GeekInternet/Alarm-Monitoring/Node-Red/Alarm Interface Flow.png

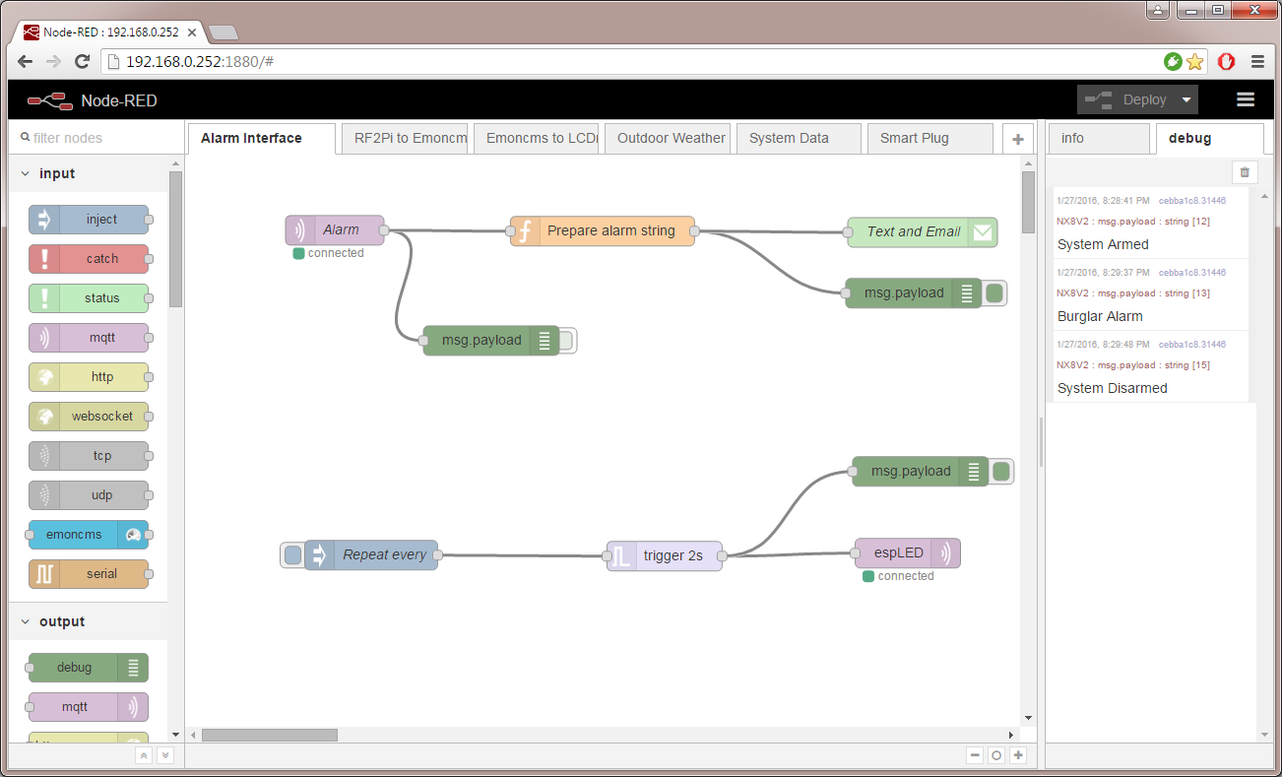
Node-Red/Alarm Interface Flow.png
