GeekInternet/Alarm-Monitoring/Schematic/Alarm Monitoring with ESP8266.pdf

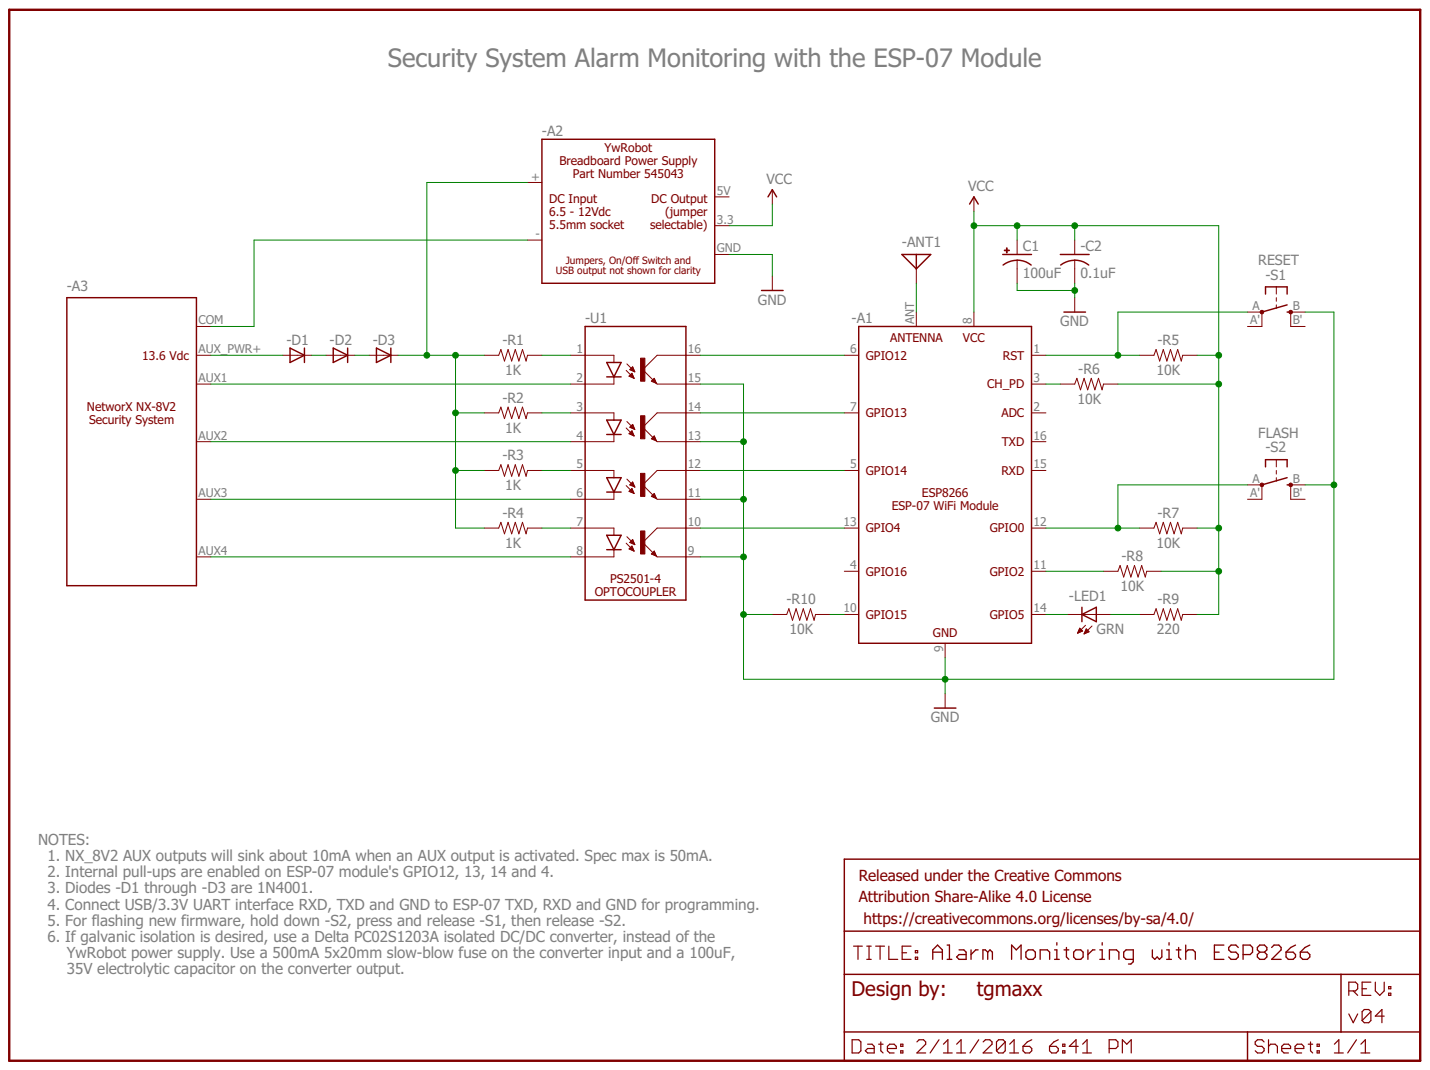
[picture p4: page 1]

Security System Alarm Monitoring with the ESP-07 Module

Jumpers, On/Off Switch and USB output not shown for clarity

NOTES: 1. NX_8V2 AUX outputs will sink about 10mA when an AUX output is activated. Spec max is 50mA. 2. Internal pull-ups are enabled on ESP-07 module's GPIO12, 13, 14 and 4. 3. Diodes -D1 through -D3 are 1N4001. 4. Connect USB/3.3V UART interface RXD, TXD and GND to ESP-07 TXD, RXD and GND for programming. 5. For flashing new firmware, hold down -S2, press and release -S1, then release -S2. 6. If galvanic isolation is desired, use a Delta PC02S1203A isolated DC/DC converter, instead of the YwRobot power supply. Use a 500mA 5x20mm slow-blow fuse on the converter input and a 100uF, 35V electrolytic capacitor on the converter output.

Released under the Creative Commons Attribution Share-Alike 4.0 License https://creativecommons.org/licenses/by-sa/4.0/
